JT-Li-2005/2026_H_Vehicle_mounted_Ball_Balancing_Motion_Control_System/信号线物理接线.md

# 信号线物理接线

## 循迹小车（Ti MSPM0G3507）

#### 1. 慧净电子 5 路灰度循迹模块 / 专利版

| MCU 引脚 | 模块信号 |
| :---: | :---: |
| B16 | OUT5 |
| B15 | OUT4 |
| B14 | OUT3 |
| A0 | OUT2 |
| A1 | OUT1 |

#### 2. DRV8701 双电机驱动板

| MCU 引脚 | 功能 |
| :---: | :---: |
| A27 | PWM1 |
| B11 | DIR1 |
| A26 | PWM2 |
| B10 | DIR2 |

> 注：电机 1 安装在左，电机 2 安装在右 

#### 3. 轮趣科技 R3X 系列三轮小车 编码器

| MCU 引脚 | 功能 |
| :---: | :---: |
| B27 | 编码器 A 相 1 |
| B26 | 编码器 B 相 1 |
| B8 | 编码器 A 相 2 |
| B9 | 编码器 B 相 2 |

>注： 电机 1 安装在左，电机 2 安装在右 

## 滚球平衡（K230）

| MCU 引脚 | 功能 |
| :---: | :---: |
| P13 | 舵机 PWM |
