JT-Li-2005/2026_H_Vehicle_mounted_Ball_Balancing_Motion_Control_System/model/readme.txt

建模文件是使用SOLIDWORKS 2024制作完成的，下载文件夹并使用SOLIDWORKS 2024打开【三维模型】.sldasm即可

为了避免不兼容，制作了STP格式版本，在“兼容格式文件夹下”

为了方便3D打印，对于需要3D打印的非标准件，制作了STL格式版本，在“3D打印”文件夹下
