JT-Li-2005/2026_H_Vehicle_mounted_Ball_Balancing_Motion_Control_System/BOM .md

# BOM 物料清单

| 名称 | 购买渠道 | 数量 | 备注 |
| :---: | :---: | :---: | :---: |
| MSPM0G3507 核心板 | 淘宝 逐飞科技 | 1个| |
| MSPM0G3507 主板拓展板 | 淘宝 逐飞科技 | 1个 | |
| DRV8701 双电机驱动板 | 淘宝 奥创电子 | 1个 | |
| R3X 系列三轮小车 | 淘宝 轮趣科技 | 1套 |已包含 MG513X 电机和霍尔编码器 |
| 杜邦线 母对母 | 淘宝 逐飞科技 | 3条 ||
| 杜邦线 公对母 | 淘宝 逐飞科技 | 24条 ||
|电源线（黑）|淘宝 逐飞科技 |1米 ||
|电源线（红）|淘宝 逐飞科技 |1米 ||
| 5 路灰度循迹模块/专利版 | 淘宝 慧净电子 | 1套| |
| CanMV K230 开发板 标准套餐| 淘宝 幻尔机器人官方商城 |1套| |
| TBSK20单轴 |淘宝 艾特科技创客教育商城 | 1个 | PWM舵机|
|四面抛光片 YS4842|淘宝 卡夫威尔工具旗舰店|1个||
| 3D 打印件 |自行3D打印 |1套 | 见model/3D打印文件夹 |
|5v5aA降压模块_USB|淘宝 深圳优信电子|1个||
|合页2寸1厘厚=48*33（6孔）|宜室五金商行 |1个| 不需要严格要求规格|
| 碳管以及三通件 | |1套 | 固定 K230 |
| 2S 电池 | 淘宝 新动模型 | 1块| 2S 至 6S 均可 |
| 魔术贴 | | 足量 | 固定电池和主板 |
| 扎带 | | 足量 | |
| AB 胶 | | 足量 | |
| 运动相机 | | 1个 | 影石、大疆等均可 |
| Pad | | 1个 | 无线连接运动相机 |

# 调试用品

| 名称 | 购买渠道 | 备注 |
| :---: | :---: | :---: |
|CMSIS-DAP调试器 有线下载器|淘宝 逐飞科技| |
|IPS2.0寸液晶显示屏|淘宝 逐飞科技| |
|nRF24L01无线串口  USB接口|淘宝 WAVGAT旗舰店| |
|nRF24L01无线串口  TTL接口|淘宝 WAVGAT旗舰店| |
|多功能舵机测试仪|淘宝 WAVGAT旗舰店| |
|读卡器|淘宝·幻尔机器人官方商城|购买 CanMV K230 开发板 时附带有，无需再单独购买|
