JT-Li-2005/2026_H_Vehicle_mounted_Ball_Balancing_Motion_Control_System/物料清单.txt

名称	                       购买渠道	                            数量	                                              备注
MSPM0G3507核心板           淘宝 逐飞科技	                            1	
MSPM0G3507主板拓展板	       淘宝 逐飞科技                             1	
DRV8701双电机驱动板		                                              1	
R3X系列三轮小车	           淘宝 轮趣科技	                            1	                                  （已含MG513X电机和霍尔编码器）
5路灰度循迹模块/专利版	     淘宝 慧净电子                              1	
CanMV K230开发板	           淘宝 幻尔机器人官方商城                     1	
舵机（含标准舵盘）		                                                 1	                                         500-2500us   270°
3D打印件（见模型文件夹）			
碳管以及三通件			                                                                                                  用于固定K230
螺丝螺母若干 			
2s电池			                                                                                                            2S至6s均可  
魔术贴			                                                                                                          用于固定电池和主板
运动相机			                                                                                                       影石 大疆等均可
Pad			                                                                                                           用于无线连接运动相机
