JT-Li-2005/2026_H_Vehicle_mounted_Ball_Balancing_Motion_Control_System/(list of files, cad)

Other CAD files:
model/水管.SLDASM
model/合页.SLDASM
model/【三维模型】.SLDASM
model/3D打印/【三维模型】 - 齿条-1.STL
model/兼容格式/【三维模型】.STEP
model/合页1.SLDPRT
model/3D打印/【三维模型】 - 水管-1 摆杆转轴侧固定座-2.STL
model/rack_gear_m1.00_z37_h10.0_b5.0.step
model/3D打印/【三维模型】 - 舵机座-1.STL
model/齿条.SLDPRT
model/3D打印/【三维模型】 - 支撑台-1.STL
model/合页2.SLDPRT
model/3D打印/【三维模型】 - 水管-1 摆杆转轴侧固定座-1.STL
model/合页3.SLDPRT
model/3D打印/【三维模型】 - 齿轮.stl
model/摆杆转轴侧固定座.SLDPRT
model/25T标准舵机舵盘.SLDPRT
model/R3X三轮差速底盘（320x240mm）【三维模型】.stp
model/PWM舵机.SLDPRT
model/支撑台.SLDPRT
model/舵机座.SLDPRT
model/水管.SLDPRT
