JT-Li-2005/2026_H_Vehicle_mounted_Ball_Balancing_Motion_Control_System/(commit log)

2026-08-20 Update and rename 物料清单.txt to 物料清单BOM.txt
2026-08-20 Update BOM (1).md
2026-08-20 Restore BOM 物料清单 table format
2026-08-20 Rename BOM (1).md to BOM .md
2026-08-20 Update BOM .md
2026-08-27 add all 3D CAD model files
    [25T标准舵机舵盘.SLDPRT, PWM舵机.SLDPRT, R3X三轮差速底盘（320x240mm）【三维模型】.stp, rack_gear_m1.00_z37_h10.0_b5.0.step, 【三维模型】 - 支撑台-1.STL, 【三维模型】 - 水管-1 摆杆转轴侧固定座-1.STL, 【三维模型】 - 水管-1 摆杆转轴侧固定座-2.STL, 【三维模型】 - 舵机座-1.STL]
2026-08-27 3D CAD model
    [25T标准舵机舵盘.SLDPRT, PWM舵机.SLDPRT, R3X三轮差速底盘（320x240mm）【三维模型】.stp, rack_gear_m1.00_z37_h10.0_b5.0.step, 【三维模型】 - 支撑台-1.STL, 【三维模型】 - 水管-1 摆杆转轴侧固定座-1.STL, 【三维模型】 - 水管-1 摆杆转轴侧固定座-2.STL, 【三维模型】 - 舵机座-1.STL]
2026-08-27 Refactor PID parameters and comments for clarity
    Updated comments for clarity and adjusted PID_KD value.
2026-08-27 Clarify rolling control module usage and PID tuning
    Updated the README to clarify usage instructions for the rolling control module and provided details on PID parameter tuning for the tracking module.
